bloutix/Mazda_MDDeck_emulator/README.md

# Mazda_MDDeck_emulator
Emulator for MD Deck input on Mazda 6 and Mazda RX8 radio main unit

this is work in progress based on Nikosapi work about Mazda tape deck emulator and Mazda Radio BUS protocol

Functionnality:
  - Emulation of MD Deck (receive data from radio and reply to main unit)
  - Aux activation without need of specifical radio firmware
  - Receiving steering wheel and radio command information
  - Sending data for car computer or RPI or other over USB
  - Keyboard emulation for OpenAuto Pro, (sending steering command to RPI)
