bloutix/Mazda_MDDeck_emulator/doc/Sample Data Bus.pdf

## Mazda Entertainment System - Sample Bus Data Dumps

Jump to navigationJump to search
The following are a bunch of dumps from the data bus to help people understand how the protocol works.

The dump format is:

timecode command

- timecode is [seconds in epoch].[fraction of a second]
- command is a hexadecimal representation of the data on the bus

NOTE: The timestamps are horribly wrong. You'll notice that some commands occur in less than 1ms which is impossible. I'm guessing that those closely-spaced packs of data were held up in some kernel buffer before being read. That explains why they appear to have happened so close together. The timestamps are still useful for seeing how the commands are sent in bursts but please do not rely on them.

A list of events is provided at the top of each dump to help the reader know when a specific action was taken and what commands were sent because of that action.

Contents

- 1Base Unit
o 1.1Initialization (no peripherals connected)
- 2CD Deck
o 2.1Initialization and playback
o 2.2Seeking
o 2.3Random/Repeat
o 2.4Load/Eject
- 3Tape Deck
o 3.1Initialization and playback o 3.2Seeking
o 3.3Random/Repeat/Dolby
o 3.4Load/Eject
- 4Tape Deck and CD Deck
o 4.1Initialization (no disk in CD Deck, no cassette in Tape Deck)
o 4.2Initialization (with disk in the CD Deck, and a cassette in the Tape Deck)
- 5See Also

## Base Unit

Initialization (no peripherals connected)

Events:
1281462287.476655 - Radio is powered-on

1281462287.476655 38C*
1281462287.476734 089
1281462287.476770 18A
1281462287.476801 68F
1281462287.476831 58E
1281462287.476862 780
1281462288.040639 38C
1281462288.040717 089
1281462288.040752 18A
1281462288.040784 68F
1281462288.040814 58E
1281462288.040845 780
1281462288.656645 38C
1281462288.656726 089
1281462288.656762 18A
1281462288.656794 68F
1281462288.656826 58E
1281462288.656858 780
1281462289.272641 38C
1281462289.272716 089
1281462289.272752 18A
1281462289.272785 68F
1281462289.272817 58E
1281462289.272849 780

## CD Deck

Initialization and playback

Events:
1281461783.680635 - Radio is powered-on (with disk in CD Deck)
1281461796.240642 - "CD" button is pressed 1281461818.376646 - "POWER" button is pressed (base unit now in standby mode)
1281461831.444645 - "POWER" button is pressed (base unit wakes up)

1281461783.680635 38C*
1281461783.680714 089
1281461783.680749 B813
1281461783.680779 18A
1281461784.112651 BBA0006000C1 1281461784.112740 68F
1281461784.112775 58E
1281461784.112807 780
1281461784.112838 39B
1281461784.320651 BB91000000C5 1281461784.320738 089
1281461785.124654 BB91000000C5 1281461785.124744 18A
1281461785.124780 68F
1281461785.124812 58E
1281461785.124843 780
1281461785.124874 089
1281461785.124905 18A
1281461785.124935 68F
1281461785.124965 58E
1281461785.124994 780
1281461785.604641 089
1281461785.604722 18A
1281461785.604759 68F
1281461785.604790 58E
1281461785.604820 780
1281461786.068638 39B
1281461786.228857 BB91000000C5 1281461786.468658 BD1000000000008000 1281461786.648654 BC00000000008 1281461786.864658 B9000010000000C0 1281461796.240642 39B*
1281461796.400648 BB91000000C5 1281461796.640654 BD1000000000008000 1281461796.808649 BC00000000008 1281461797.120650 B9000010000000C0 1281461797.120745 3110121
1281461797.328653 B940001000000017 1281461797.540655 B940001000000017 1281461800.068653 B940101000000018 1281461800.244651 BC101104138F8 1281461800.460650 B950101000000017 1281461800.712651 B940101000000018 1281461800.924659 B940101000000018

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
1281469980.420734 890CE
1281469981.280650 BBA0006000C1

Initialization (with disk in the CD Deck, and a cassette in the Tape Deck)

Events:
1281470594.792638 - Radio is powered-on

1281470594.792638 38C*
1281470594.792721 089
1281470594.792758 B813
1281470594.792791 8812

1281470594.792825 18A
1281470595.216648 8B90400C3 1281470595.216736 68F
1281470595.216772 BBA0
1281470595.216806 58E
1281470595.216839 780
1281470595.216872 18A
1281470595.640713 BB91000000C5 1281470595.640800 68F
1281470595.640836 58E
1281470595.640869 780
1281470595.640903 39B
1281470595.848644 BB91000000C5 1281470595.848728 18A
1281470596.120766 BD1000000000008000 1281470596.120865 68F
1281470596.328656 BC00000000008 1281470596.328751 58E
1281470596.876848 B9000010000000C0 1281470596.876944 780
1281470596.876980 18A
1281470596.877014 68F
1281470596.877047 58E
1281470596.877079 780
1281470597.628638 39B
1281470597.784649 BB91000000C5 1281470598.024853 BD1000000000008000 1281470598.204658 BC00000000008 1281470598.460651 B9000010000000C0 1281470598.460740 09A
1281470598.664645 8B90400C3 1281470598.664731 890CE
