bloutix/Mazda_MDDeck_emulator/doc/mazdaspoof-1.0/schematics/mazdaspoof.png

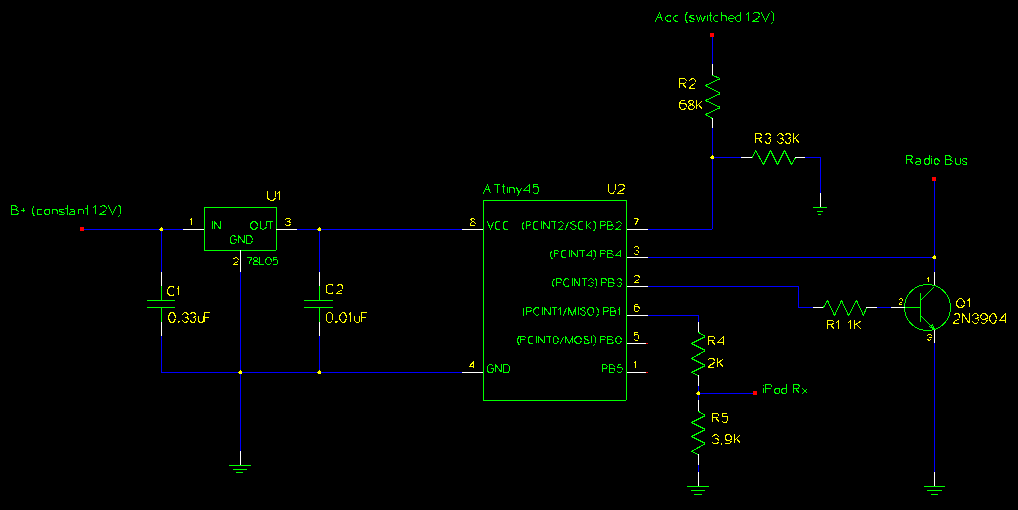
doc/mazdaspoof-1.0/schematics/mazdaspoof.png
