bloutix/Mazda_MDDeck_emulator/(commit log)

2024-02-18 adding src of document
    [ipod-ps.sch, ipod.sch, mazdaspoof.sch]
2024-02-25 Update Command from head unit
    Fixed:
    - Forwarding and Rewinding command
    - Track number integration
    - Automatic LRC checksum function
    - Better wakeup response
    - Fastest reply response
    [MDDesk_emu.ino]
